reindeer199/LiFePO4_for_ebike/README.md

# LiFePO4_for_ebike
replace LiIon battery by LiFePO4 for ebike

Hier beschreibe ich wie ich den altersschwachen Li Ionen Akku meines Ebikes mit einen LiFePO4 Akku ersetzt habe.

Weshalb LiFePO4? Vorteile gegenüber LiIon sind:

    • LiFePO4 Akkus gehen nicht thermisch durch, d.h. keine Brandgefahr
    • sie erlauben deutlich mehr Ladezyklen
    • längere Lebensdauer
    • unempfindlicher gegen Hitze und Kälte (Entladetemperatur -20 .. 60°C)
    • weniger Gefahrstoffe; umweltfreundlicher bei Herstellung und Entsorgung
    • günstigerer Preis
Nachteile sind:

    • mehr Gewicht / Volumen

Leider wird LiFePO4 für Ebikes nicht fertig passend angeboten. Also habe ich beschlossen selbst was zu bauen.
