reindeer199/LiFePO4_for_ebike/LiFePO/StateMachine.odp

NEW

INIT

BatteryStatus |=
BATT_STAT_INIT

CHARGE

BatteryStatus &=
!BATT_STAT_DISCHARGING

Current < 0

DISCHARGE

BatteryStatus |=
BATT_STAT_DISCHARGING

Current > -20

Ctr_NL = 0

NACHLAUF

Ctr_NL++

Ctr_NL > 120

Current > 20

Current < -30

SHUTDOWN

EepWrite(Capacity)

Power Off
