reindeer199/LiFePO4_for_ebike/LiFePO/LiFePO_HW_version.h

/*  LiFePO Hardware Versions	*/

#define HW_version 21

#if (HW_version == 21)
/***************************/
    // digital PINs Hardware V2_1
    #define PWM_OUT 3  // high: pwr is switched on, else off
    #define MON_ADC 8 //monitor ADC high when ADC data aquisition
    #define MON_REQ 7 //monitor I2C high when requested data is sent
    #define MON_I2C 6 //monitor I2C high after message received, low when received data copied into buffer
    #define MON_WDT 9 //monitor watchdog high after new cycle startet, low when idle
    #define BMS_OUT E0 //not used
    #define LED_RED 5  // optional LED1 high LED is on
    #define CHARGE  4  // input for reading charge switch
    #define PWM_INT 2  // input for SDA interrupt

    // analog PINs Hardware V2_1
    #define BAT_EMPTY  PIN_A6 // Diagnose BMS hat Last abgeschaltet
    #define V_24  PIN_A7 // unbenutzt
    #define V_36  PIN_A3
    #define V_INT PIN_A2
    #define I_OUT PIN_A0
    #define I_IN  PIN_A1
    
    // Scaling Hardware V2_1
    // in mA or mV @ ADC 1023
    #define FAKTOR_CURRENT_IN 2240
    #define FAKTOR_CURRENT_OUT 10368
    #define FAKTOR_VOLTAGE_12 14583
    #define FAKTOR_VOLTAGE_24 28520
    #define FAKTOR_VOLTAGE_36 42199
    #define FAKTOR_VOLTAGE_INT 39405
    // Offsets in mA
    #define OFFSET_CURRENT_IN 20
    #define OFFSET_CURRENT_OUT1 162
    // offsetverschiebung bei current_in = 1A (Wert muss < 14 sein damit OFFSET_CURRENT_OUT2 * current in INT16 passt!)
    #define OFFSET_CURRENT_OUT2 13

    // max. capacity of battery is 10Ah = 10000mAh
    #define MAX_CAPACITY 10000
#endif

/***************************/
#if (HW_version == 1)
/***************************/
    // digital PINs Hardware V01
    #define PWM_OUT 3
    #define MON_ADC 8
    #define MON_REQ 7
    #define MON_I2C 6
    #define MON_WDT 5
    #define BMS_OUT 9

    // analog PINs Hardware V01
    #define V_12 PIN_A2
    #define V_24 PIN_A3
    #define V_36 PIN_A6
    #define V_INT PIN_A7
    #define I_OUT PIN_A0
    #define I_IN PIN_A1
    
    // mA or mV @ ADC 1023
    #define FAKTOR_CURRENT_IN 2414
    #define FAKTOR_CURRENT_OUT 10735
    #define FAKTOR_VOLTAGE_12 14514
    #define FAKTOR_VOLTAGE_24 28776
    #define FAKTOR_VOLTAGE_36 43234
    #define FAKTOR_VOLTAGE_INT 52140
    // Offsets
    #define OFFSET_CURRENT_IN 28
    #define OFFSET_CURRENT_OUT 12

    // max. capacity of battery is 9Ah = 9000mAh
    #define MAX_CAPACITY 9000
#endif    
#if (HW_version == 2)
/***************************/

/***************************/
    // digital PINs Hardware V02
    #define PWM_OUT 3
    #define MON_ADC 8
    #define MON_REQ 7
    #define MON_I2C 6
    #define MON_WDT 5
    #define BMS_OUT 9

    // analog PINs Hardware V02
    #define V_12 PIN_A2
    #define V_24 PIN_A3
    #define V_36 PIN_A6
    #define V_INT PIN_A7
    #define I_OUT PIN_A0
    #define I_IN PIN_A1
    
    // in mA or mV @ ADC 1023
    #define FAKTOR_CURRENT_IN 2394
    #define FAKTOR_CURRENT_OUT 9411
    #define FAKTOR_VOLTAGE_12 14514
    #define FAKTOR_VOLTAGE_24 28421
    #define FAKTOR_VOLTAGE_36 42513
    #define FAKTOR_VOLTAGE_INT 40100
    // Offsets in mA
    #define OFFSET_CURRENT_IN 45
    #define OFFSET_CURRENT_OUT 283
    // max. capacity of battery is 9Ah = 9000mAh
    #define MAX_CAPACITY 9000
/***************************/
#endif
#if (HW_version == 3)
/***************************/
    // digital PINs Hardware V03
    #define PWM_OUT 3
    #define MON_ADC 8
    #define MON_REQ 7
    #define MON_I2C 6
    #define MON_WDT 5
    #define BMS_OUT 9
    #define LED_RED 31

    // analog PINs Hardware V03
    #define V_12 PIN_A0
    #define V_24 PIN_A1
    #define V_36 PIN_A2
    #define V_INT PIN_A3
    #define I_OUT PIN_A6
    #define I_IN PIN_A7
    
    // Scaling Hardware V03
    // in mA or mV @ ADC 1023
    #define FAKTOR_CURRENT_IN 2307
    #define FAKTOR_CURRENT_OUT 9382
    #define FAKTOR_VOLTAGE_12 14583
    #define FAKTOR_VOLTAGE_24 28520
    #define FAKTOR_VOLTAGE_36 42191
    #define FAKTOR_VOLTAGE_INT 39000
    // Offsets in mA
    #define OFFSET_CURRENT_IN 34
    #define OFFSET_CURRENT_OUT 191

    // max. capacity of battery is 9Ah = 9000mAh
    #define MAX_CAPACITY 9000
#endif
