reindeer199/LiFePO4_for_ebike/(commit log)

2025-04-07 Stromaufnahme der I2C Pins reduziert Versuch Vint Unterspannungen zu vermeiden Statemachine überarbeitet
2025-08-05 Schwellen für PWM angepasst Umbenennungen Kommentare angepasst
2026-06-20 Capacity-- @ Init to avoid sporadic reset of km-counter
    [LiFePO.ino]
